linchingsu/HumanoidRobot/README.md

# HumanoidRobot
Development of a humanoid robot to simulate patient's behaviors for nursing students to practice patient handling skills
