linchingsu/HumanoidRobot/Program flowchart.PNG

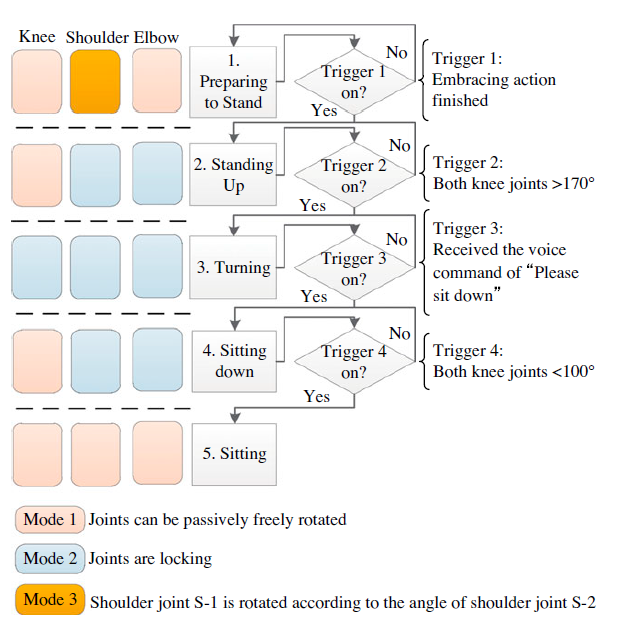
Program flowchart.PNG
